juancalderonlaratilin-ai/micro3/docs/informe/informe_adc_uart_ieee.tex

% Compilar con XeLaTeX o LuaLaTeX (en Overleaf: Menu -> Compiler -> XeLaTeX)
\documentclass[11pt,letterpaper]{article}

% ---------------------------------------------------------------- página y fuente
\usepackage[margin=0.85in]{geometry}
\usepackage{fontspec}
\setmainfont{TeX Gyre Termes}          % tipo Times, como IEEE
\usepackage{amsmath,amssymb}
\usepackage{microtype}
\usepackage{booktabs,tabularx,array,float}
\usepackage{graphicx}
\usepackage{placeins}
\usepackage{enumitem}
\usepackage{titlesec}
\usepackage{caption}
\usepackage{xcolor}
\usepackage[hidelinks]{hyperref}
\usepackage[output-decimal-marker={,},group-separator={\,},group-minimum-digits=4,
            per-mode=symbol]{siunitx}

% ---------------------------------------------------------------- textos en español
\renewcommand{\tablename}{Tabla}
\renewcommand{\refname}{Referencias}
\renewcommand{\abstractname}{Resumen}
\renewcommand{\figurename}{Fig.}

% ---------------------------------------------------------------- estilo IEEE
\renewcommand{\thesection}{\Roman{section}}
\renewcommand{\thesubsection}{\Alph{subsection}}
\titleformat{\section}{\centering\scshape\large}{\thesection.}{0.5em}{}
\titleformat{\subsection}{\itshape}{\thesubsection.}{0.5em}{}
\titlespacing*{\section}{0pt}{1.3em}{0.6em}
\titlespacing*{\subsection}{0pt}{1.1em}{0.5em}

\renewcommand{\thetable}{\Roman{table}}
\captionsetup[table]{labelfont=sc, textfont=sc, labelsep=newline,
                     justification=centering, skip=6pt, font=small}
\captionsetup[figure]{labelsep=period, font=small, justification=justified, skip=4pt}

\setlength{\parindent}{1.2em}
\setlength{\parskip}{0.3em}
\renewcommand{\arraystretch}{1.2}
\setlength{\tabcolsep}{6pt}
\newcolumntype{Y}{>{\raggedright\arraybackslash}X}
\setlist{itemsep=0pt, topsep=3pt}

\definecolor{elegido}{RGB}{0,82,147}
\newcommand{\elegido}[1]{\textcolor{elegido}{#1}}   % resalta la opción elegida

\begin{document}

% ================================================================ título
\begin{center}
  {\LARGE Configuración del ADC y la UART del PIC16F18426\\[0.25em]
  en el instrumento de corrientes de Eddy}\\[0.9em]
  {\large Proyecto Micro 3 --- Microcontroladores}\\[0.3em]
  {\small Resumen de decisiones de diseño}
\end{center}

\vspace{0.6em}
\begin{abstract}
\noindent
El PIC16F18426 digitaliza las componentes en fase ($I$) y en cuadratura ($Q$) que entrega la placa de demodulación y las envía a un PC por UART. Este documento reúne, en un solo lugar, \emph{qué} se escogió para el ADC y la UART y \emph{por qué}, con los cálculos mínimos de cada valor. Los datos viajan como texto ASCII, una línea \texttt{2048,2051\textbackslash r\textbackslash n} por par. Resultado: muestreo de $I$ y $Q$ a \SI{1}{\kilo\hertz} disparado por hardware, enlace a \num{115200} baudios 8N1 y una línea cada dos pares (500 líneas/s), que ocupa el \SI{48}{\percent} de la línea; una línea por par la dejaría al \SI{96}{\percent}, sin margen.
\end{abstract}

% ================================================================ I
\section{Datos del sistema}

\noindent
PIC16F18426 (14 pines, 8 bits) con oscilador interno HFINTOSC a $F_\text{osc} = \SI{16}{\mega\hertz}$ (\SI{+-2}{\percent}), así que $T_\text{CY} = 4/F_\text{osc} = \SI{250}{\nano\second}$. Alimentación $V_{DD} = \SI{3.7}{\volt}$, accesible en J1, en TP3 y en el pin 2 de J4. Las señales $I$ (RC0) y $Q$ (RC1) llegan centradas en $V_\text{ref2} = \SI{1.85}{\volt}$, con banda de $\lesssim \SI{20}{\hertz}$. El enlace al PC es EUSART1 $\rightarrow$ traductores SN74LVC1T45 $\rightarrow$ CP2102 (USB) $\rightarrow$ LabVIEW o Python.

% ================================================================ II
\section{UART: qué se escogió y por qué}

La Tabla~\ref{tab:uart} resume cada decisión; abajo están los cálculos.

\begin{table}[!htb]
\caption{Decisiones de la UART}\label{tab:uart}
\centering
\begin{tabularx}{\textwidth}{@{}l>{\raggedright\arraybackslash}p{0.27\textwidth}Y@{}}
\toprule
\textbf{Parámetro} & \textbf{Elegido} & \textbf{Por qué} \\
\midrule
Modo & EUSART1 asíncrono, \textbf{8N1} & Estándar: lo acepta cualquier terminal, LabVIEW o Python sin configuración especial. \\
Velocidad & \textbf{\num{115200} baud} (\num{114286} reales) & Es el baud estándar más bajo donde caben 500 líneas/s de 11 bytes: ocupan el \SI{48}{\percent}. A \num{9600} y \num{19200} baud serían el \SI{573}{\percent} y el \SI{286}{\percent}; a \num{57600}, el \SI{95}{\percent}, sin margen. \\
Generador de baud & \texttt{BRGH}\,=\,1, \texttt{BRG16}\,=\,1, \texttt{SP1BRG}\,=\,34 & Error de \SI{-0.79}{\percent}; con el generador de 8 bits sería \SI{-3.55}{\percent}. \\
Pines & TX = RC4, RX = RC5 (PPS) & No chocan con el ADC (RC0, RC1) ni con el programador (RA0, RA1, RA3). \\
Nivel de RX & TTL (\texttt{INLVLC5}\,=\,0) & $V_{IH} = \SI{1.73}{\volt}$: \SI{1.57}{\volt} de margen con \SI{3.3}{\volt}. Con Schmitt serían \SI{2.96}{\volt}. \\
Capa física & 2 $\times$ SN74LVC1T45 & El CP2102 admite como máximo $V_{IO} + \SI{0.5}{\volt} = \SI{3.8}{\volt}$; el PIC saca \SI{3.7}{\volt}. \\
Atención & Interrupción de TX & Nada espera: prohibidos \texttt{while(!TX1IF)} y \texttt{\_\_delay\_ms}. El RX queda configurado, pero el PIC no recibe comandos. \\
Buffers & Circulares: RX \num{32} B, TX \num{64} B & Potencias de 2: el índice avanza con \texttt{(i+1)\,\&\,(N-1)}, sin división. TX guarda 4 líneas. \\
Envío & \texttt{tx\_DAT()}, \texttt{tx\_string()} & Todo o nada: nunca sale media línea; si no cabe, devuelven \texttt{false} sin esperar. \\
Formato & \textbf{Texto ASCII}, \texttt{xxxx,xxxx\textbackslash r\textbackslash n} & Ver la sección~\ref{sec:formato}. \\
\bottomrule
\end{tabularx}
\end{table}

\subsection{Cálculo del baud}
Con \texttt{BRGH}\,=\,1 y \texttt{BRG16}\,=\,1:
\begin{gather}
  \text{Baud} = \frac{F_\text{osc}}{4\,(\text{SP1BRG}+1)} = \frac{\SI{16}{\mega\hertz}}{4\,(34+1)} = \num{114286}\ \text{baud} \\[2pt]
  \text{error} = \frac{\num{114286} - \num{115200}}{\num{115200}} = \SI{-0.79}{\percent}
\end{gather}
La fórmula de 8 bits, $\text{Baud} = F_\text{osc}/[16(\text{SP1BRG}+1)]$, da $\text{SP1BRG} = 7{,}68 \rightarrow 8$ y \num{111111} baud (\SI{-3.55}{\percent}), demasiado lejos si se suma el \SI{+-2}{\percent} del oscilador.

\textbf{Tolerancia.} El receptor muestrea el bit de parada a 9,5 bits del flanco de inicio, así que el desfase total debe ser menor que $0{,}5/9{,}5 = \SI{+-5.3}{\percent}$ (en la práctica, entre \SI{2}{\percent} y \SI{3}{\percent}). Peor caso: $\SI{-0.79}{\percent} - \SI{2}{\percent} \approx \SI{-2.8}{\percent}$: funciona.

\textbf{Tiempos.} $T_\text{bit} = \SI{8.75}{\micro\second}$, byte 8N1 (10 bits) $= \SI{87.5}{\micro\second}$, capacidad $\approx \SI{11429}{\byte\per\second}$.

\textbf{Verificado:} eco a \num{115200} baud con 20/20, 256/256 y 1000/1000 bytes sin errores (2026-10-19).

% ================================================================ III
\section{ADC: qué se escogió y por qué}

La Tabla~\ref{tab:adc} resume cada decisión; abajo están los cálculos.

\begin{table}[!htb]
\caption{Decisiones del ADC}\label{tab:adc}
\centering
\begin{tabularx}{\textwidth}{@{}l>{\raggedright\arraybackslash}p{0.27\textwidth}Y@{}}
\toprule
\textbf{Parámetro} & \textbf{Elegido} & \textbf{Por qué} \\
\midrule
Convertidor & ADCC de 12 bits, modo básico, resultado a la derecha & 4096 niveles; 1 LSB $= \SI{0.903}{\milli\volt}$. \\
Referencia & $V_\text{ref+} = V_{DD} = \SI{3.7}{\volt}$ (\texttt{ADREF}\,=\,0x00) & Cubre 0 a \SI{3.7}{\volt} sin recorte y es ratiométrica: $V_\text{ref2}$ sale de un divisor del mismo riel, así que el reposo queda en 2048 aunque $V_{DD}$ varíe. FVR de \SI{2.048}{\volt}: recorta; FVR de \SI{4.096}{\volt}: no puede superar $V_{DD}$. \\
Canales & $I$ = RC0 (0x10), $Q$ = RC1 (0x11) & Un solo ADC multiplexado: $I$ y luego $Q$ en ráfaga. \\
Muestreo & $f_s = \SI{1}{\kilo\hertz}$ & Pedido por el profesor. Con señal $\lesssim \SI{20}{\hertz}$: sobremuestreo de 25; Nyquist en \SI{500}{\hertz}. Al PC llega 1 de cada 2 pares (\SI{500}{\hertz}). \\
Disparo & Timer0 por hardware (\texttt{ADACT}\,=\,0x02) & El instante de $I$ no depende del software (sin jitter de código). El Timer2 queda para el PWM. \\
Timer0 & $F_\text{osc}/4$, prescaler 1:16, \texttt{TMR0H}\,=\,249 & Periodo exacto de \SI{1000}{\micro\second} sin recargar por software. \\
Reloj del ADC & $T_{AD} = \SI{2}{\micro\second}$ (\texttt{ADCLK} $= F_\text{osc}/32$) & Dentro del rango permitido (0,5 a \SI{9}{\micro\second}); conversión de \SI{28.5}{\micro\second}. \\
Adquisición & \texttt{ADACQ}\,=\,160 & El datasheet es ambiguo: 10, 40 o \SI{320}{\micro\second}. Los tres casos caben en 1 ms; se mide con el pin marcador. \\
Promedio & Ninguno & Cada línea lleva una sola muestra de $I$ y una de $Q$. \\
Entrada al pin & \SI{1}{\kilo\ohm} en serie + \SI{10}{\nano\farad} a GND & Aísla al operacional MCP604 de la carga del S\&H y sirve de depósito de carga. Pide $T_\text{ACQ} \gtrsim \SI{40}{\micro\second}$ (ver abajo). \\
\bottomrule
\end{tabularx}
\end{table}

\subsection{Cálculos}
\begin{gather}
  1\ \text{LSB} = \frac{V_{DD}}{4096} = \SI{0.9033}{\milli\volt}, \qquad
  N(\SI{1.85}{\volt}) = \frac{1{,}85}{3{,}7}\times 4096 = 2048 \\[2pt]
  T_s = (\texttt{TMR0H} + 1)\cdot \frac{16}{F_\text{osc}/4} = 250 \times \SI{4}{\micro\second} = \SI{1000}{\micro\second} \\[2pt]
  T_\text{conv} = 14\,T_{AD} + 2\,T_\text{CY} = 14(\SI{2}{\micro\second}) + 2(\SI{0.25}{\micro\second}) = \SI{28.5}{\micro\second}
\end{gather}

\textbf{Calidad.} El ideal de 12 bits es $\text{SINAD} = 6{,}02\cdot 12 + 1{,}76 = \SI{74}{\decibel}$. El requisito de \SI{60}{\decibel} equivale a $\text{ENOB} = (60-1{,}76)/6{,}02 = 9{,}67$ bits: con una senoidal a escala completa (\SI{1.31}{\volt} rms) se permiten \SI{1.31}{\milli\volt} rms de ruido y distorsión, unos 1,45 LSB. El ruido de cuantización es $\text{LSB}/\sqrt{12} = \SI{0.261}{\milli\volt}$ rms.

\textbf{Sesgo entre $I$ y $Q$.} La muestra de $Q$ se toma $\approx \SI{46}{\micro\second}$ después de la de $I$ (con \SI{10}{\micro\second} de adquisición). A \SI{20}{\hertz} eso es $360^\circ \cdot 20 \cdot \SI{46}{\micro\second} = 0{,}33^\circ$ de error de fase: despreciable.

\textbf{Red de \SI{1}{\kilo\ohm} + \SI{10}{\nano\farad}.} Al conectarse el capacitor interno ($C_\text{HOLD} = \SI{28}{\pico\farad}$), el pin salta solo $28/10\,028 = \SI{0.28}{\percent}$ de la diferencia con el canal anterior. Luego se recupera con $\tau = \SI{1}{\kilo\ohm}\cdot\SI{10}{\nano\farad} = \SI{10}{\micro\second}$. La mezcla de $I$ en $Q$ queda en \SI{-60}{\decibel} con \SI{10}{\micro\second} de adquisición y en \SI{-86}{\decibel} con \SI{40}{\micro\second}; por eso no conviene acortarla por debajo de unos \SI{40}{\micro\second}.

% ================================================================ IV
\section{Formato de los datos: texto ASCII}
\label{sec:formato}

\subsection{La línea que se transmite}

\begin{table}[!htb]
\caption{Línea de texto. Ejemplo: $I = 2048$, $Q = 2051$}
\centering
\begin{tabular}{@{}lccccccccccc@{}}
\toprule
\textbf{Byte} & 0 & 1 & 2 & 3 & 4 & 5 & 6 & 7 & 8 & 9 & 10 \\
\textbf{Carácter} & \texttt{2} & \texttt{0} & \texttt{4} & \texttt{8} & \texttt{,} & \texttt{2} & \texttt{0} & \texttt{5} & \texttt{1} & CR & LF \\
\textbf{Hex} & \texttt{32} & \texttt{30} & \texttt{34} & \texttt{38} & \texttt{2C} & \texttt{32} & \texttt{30} & \texttt{35} & \texttt{31} & \texttt{0D} & \texttt{0A} \\
\bottomrule
\end{tabular}
\end{table}

\noindent
$I$ y $Q$ van en decimal, de 0 a 4095, sin ceros a la izquierda: hasta 11 bytes por línea. Primero va $I$ y después $Q$, sin nombres: el orden dice cuál es cuál. Dos números separados por coma los dibuja directo el Serial Plotter de Arduino. El PC lee hasta \texttt{\textbackslash n} y separa los números con \texttt{\%d,\%d}; una línea con otra forma se descarta.

\subsection{Cuántas líneas por segundo}

Una línea de 11 bytes tarda $11 \times \SI{87.5}{\micro\second} = \SI{962.5}{\micro\second}$, casi todo el periodo de muestreo. Por eso el PIC manda una línea cada dos pares (\texttt{ADC\_PARES\_POR\_LINEA}\,=\,2), como resume la Tabla~\ref{tab:ocup}.

\begin{table}[!htb]
\caption{Ocupación de la línea a \num{114286} baud}\label{tab:ocup}
\centering
\begin{tabularx}{\textwidth}{@{}lYYY@{}}
\toprule
 & \textbf{1 línea por par} & \textbf{\elegido{1 cada 2 pares (elegido)}} & \textbf{1 cada 50 pares} \\
\midrule
Líneas por segundo ($f_s$ en el PC) & 1000 & \textbf{500} & 20 \\
Bytes por segundo & \num{11000} & \textbf{\num{5500}} & 220 \\
Ocupación & \SI{96}{\percent}: \textbf{sin margen} & \textbf{\SI{48}{\percent}} & \SI{1.9}{\percent} \\
Nyquist en el PC & \SI{500}{\hertz} & \textbf{\SI{250}{\hertz}} & \SI{10}{\hertz} \\
Sirve para SINAD a 5 y \SI{20}{\hertz} & --- & \textbf{sí} (armónicos 2 a 5 $\le$ \SI{100}{\hertz}) & no \\
\bottomrule
\end{tabularx}
\end{table}

\subsection{Conversión a decimal en el PIC}

El PIC16 no tiene divisor por hardware, así que \texttt{a\_decimal()} saca cada cifra restando 1000, 100, 10 y 1 tantas veces como quepa (hasta 18 restas de 16 bits para 4095) y le suma \texttt{'0'} (\texttt{0x30}). Previsión: $\approx\SI{95}{\micro\second}$ por valor; con el texto fijo y la copia al buffer (\texttt{tx\_string}), $\approx\SI{280}{\micro\second}$ por línea, una vez cada \SI{2}{\milli\second}.

\subsection{Ventajas y límites}

\begin{itemize}
  \item[+] Se lee directo en una terminal o en el Serial Plotter, y el fin de línea sincroniza solo.
  \item[+] En LabVIEW basta \emph{VISA Read} con el carácter de fin \texttt{\textbackslash n} y \emph{Scan From String}; es el formato que sugiere el enunciado.
  \item[+] El PIC empieza a mandar al encenderse: el PC no tiene que pedir nada.
  \item[+] Sin nombres la línea es corta (11 bytes): a 500 líneas/s usa menos de la mitad de la UART.
  \item[$-$] El PC depende del orden: el primer número es $I$ y el segundo $Q$.
  \item[$-$] Al PC llega 1 de cada 2 pares ($f_s = \SI{500}{\hertz}$); suficiente para señales $\lesssim \SI{20}{\hertz}$.
  \item[$-$] Sin verificación de errores ni número de secuencia: una línea dañada se descarta si deja de tener la forma «número,número»; una perdida no se ve (se revisa el contador \texttt{adcLineasPerdidas} del PIC).
  \item[$-$] El PC no puede mandar comandos (el control del PWM queda por definir).
\end{itemize}

% ================================================================ V
\section{Diagramas de tiempo}

Las Figs.~\ref{fig:periodo}--\ref{fig:ocup} se generaron con el script \texttt{generar\_diagramas\_tiempo.m} (MATLAB). Los tiempos del ADC y de la UART son exactos: salen del datasheet (conversión de \SI{28.5}{\micro\second}, latencia de interrupción) o de los registros (periodo de \SI{1}{\milli\second}, \num{114286} baud, línea de \SI{962.5}{\micro\second}). Los tiempos de CPU son una \emph{previsión}: se estimaron contando instrucciones a 4 instrucciones/\si{\micro\second} y se medirán con un pin marcador y el osciloscopio. Todas las figuras suponen una adquisición de \SI{10}{\micro\second}.

\begin{figure}[!ht]
\centering
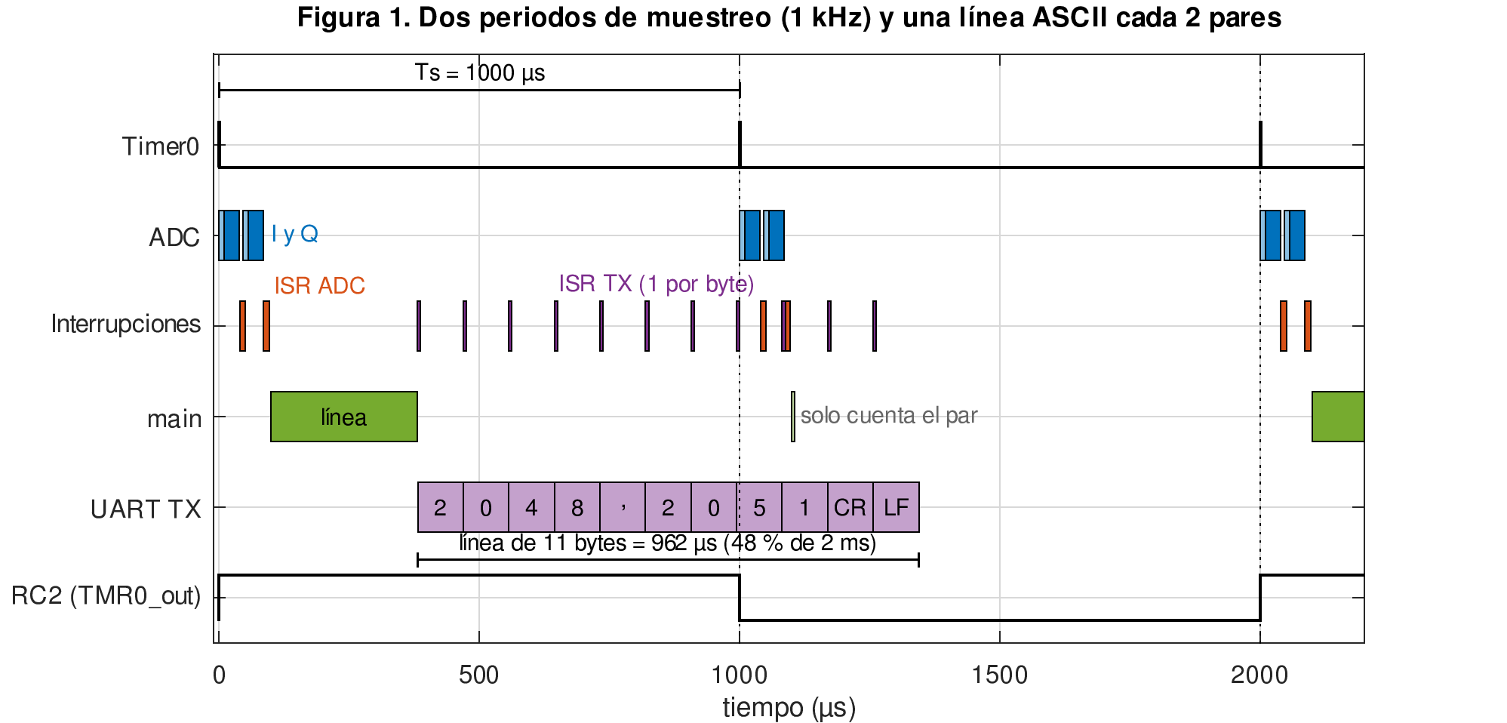
[picture p1: docs/informe/figuras/fig1_periodo_2ms.png]

\caption{Dos periodos de muestreo. El Timer0 dispara la conversión de $I$ por hardware en $t = 0$ y en $t = \SI{1000}{\micro\second}$; cada ráfaga $I + Q$ termina hacia los \SI{97}{\micro\second}. En el primer tick el programa principal arma la línea ($\approx$\SI{280}{\micro\second}); en el segundo solo cuenta el par. La línea ocupa la UART \SI{962.5}{\micro\second} (\SI{48}{\percent} de \SI{2}{\milli\second}) y sus interrupciones de TX caen sobre la ráfaga siguiente, donde pueden retrasar unos \SI{6}{\micro\second} el arranque de $Q$. RC2 saca la salida del Timer0: cambia de nivel en cada disparo.}
\label{fig:periodo}
\end{figure}

\begin{figure}[!ht]
\centering
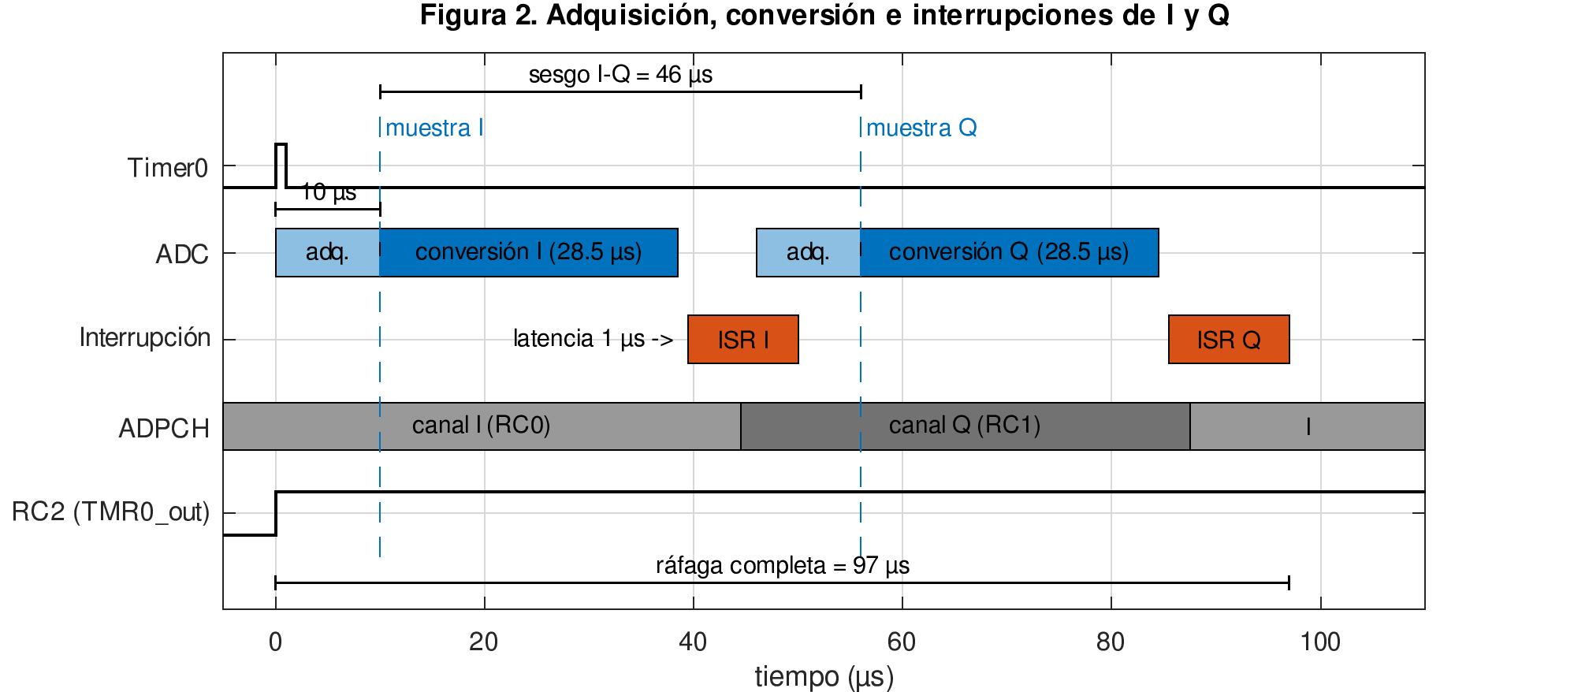
[picture p2: docs/informe/figuras/fig2_rafaga_IQ.png]

\caption{Lectura del ADC. Cada canal tiene \SI{10}{\micro\second} de adquisición y \SI{28.5}{\micro\second} de conversión ($14\,T_{AD} + 2\,T_\text{CY}$). Al terminar $I$, la interrupción (latencia de \SIrange{0.75}{1}{\micro\second}) lee \texttt{ADRES}, cambia \texttt{ADPCH} a RC1 y arranca $Q$. Por eso la muestra de $Q$ queda $\approx$\SI{46}{\micro\second} después de la de $I$.}
\label{fig:rafaga}
\end{figure}

\begin{figure}[!ht]
\centering
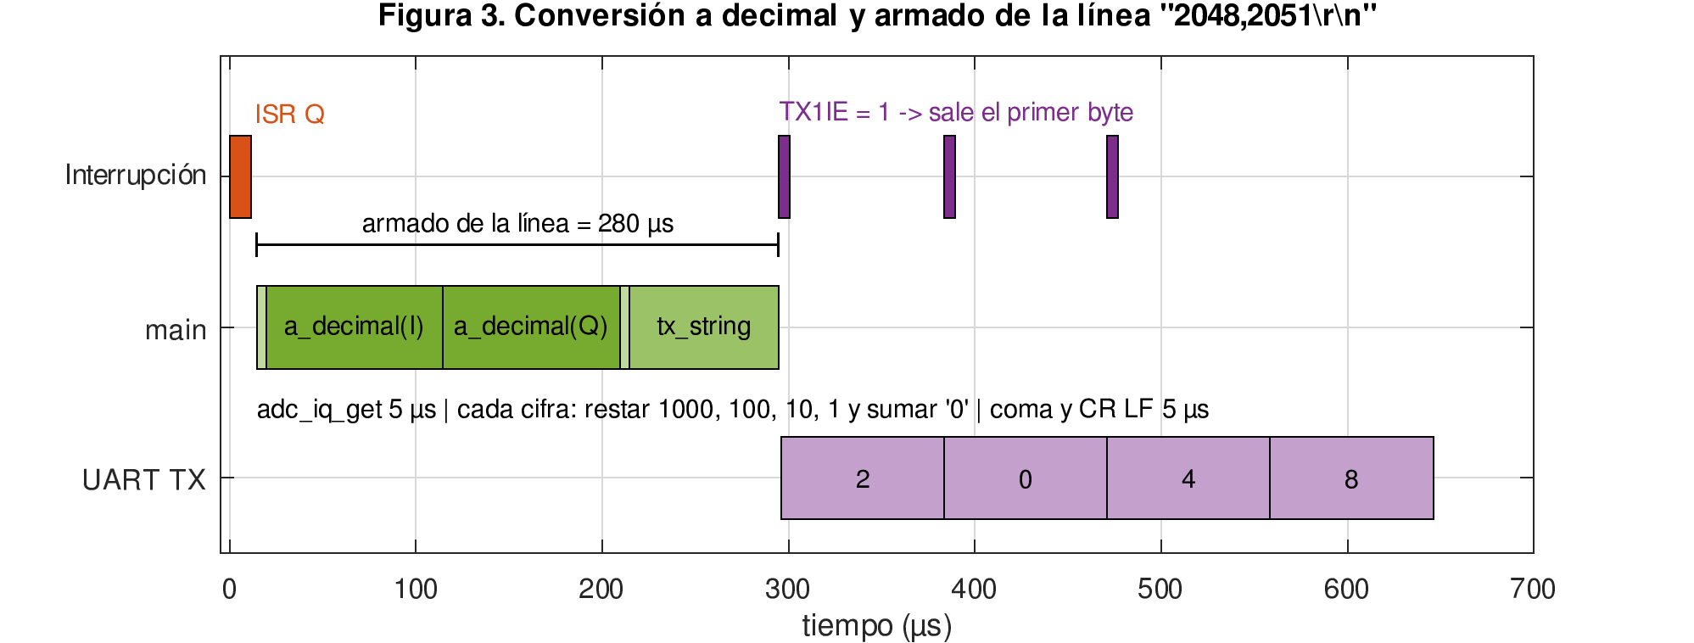
[picture p3: docs/informe/figuras/fig3_armado_linea.png]

\caption{Conversión a decimal y armado de la línea. Lo que más tarda es \texttt{a\_decimal()} ($\approx$\SI{95}{\micro\second} por valor), seguido de la copia de los 11 bytes al buffer de TX con \texttt{tx\_string} ($\approx$\SI{80}{\micro\second}). Al poner \texttt{TX1IE} = 1, la interrupción de TX carga los primeros bytes y la línea empieza a salir.}
\label{fig:armado}
\end{figure}

\begin{figure}[!ht]
\centering
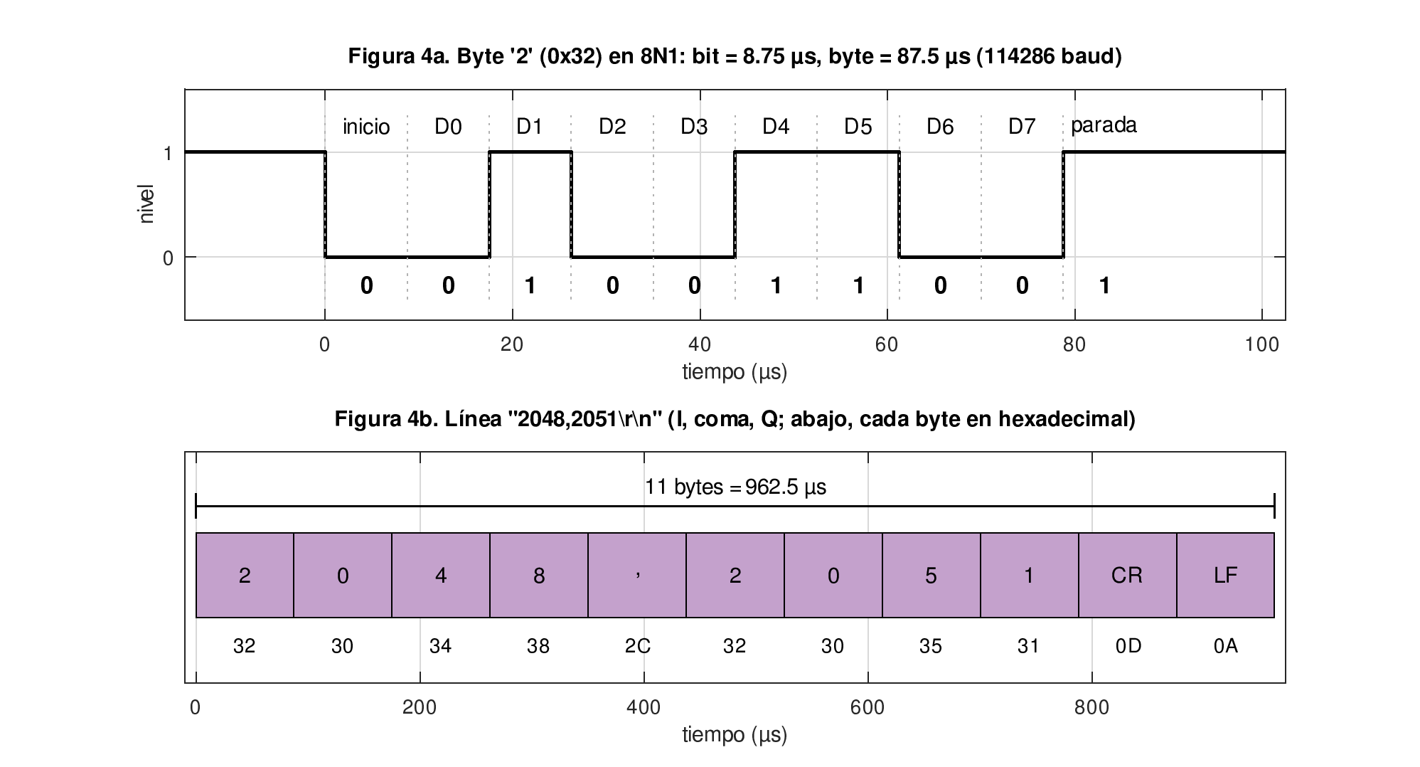
[picture p4: docs/informe/figuras/fig4_byte_linea.png]

\caption{(a) Byte \texttt{'2'} (\texttt{0x32}) en la línea: bit de inicio en 0, los 8 datos empezando por el menos significativo (0,1,0,0,1,1,0,0) y bit de parada en 1. Cada bit dura \SI{8.75}{\micro\second} y el byte \SI{87.5}{\micro\second}. (b) Línea completa del ejemplo $I = 2048$, $Q = 2051$: 11 bytes, \SI{962.5}{\micro\second}.}
\label{fig:byte}
\end{figure}

\begin{figure}[!ht]
\centering
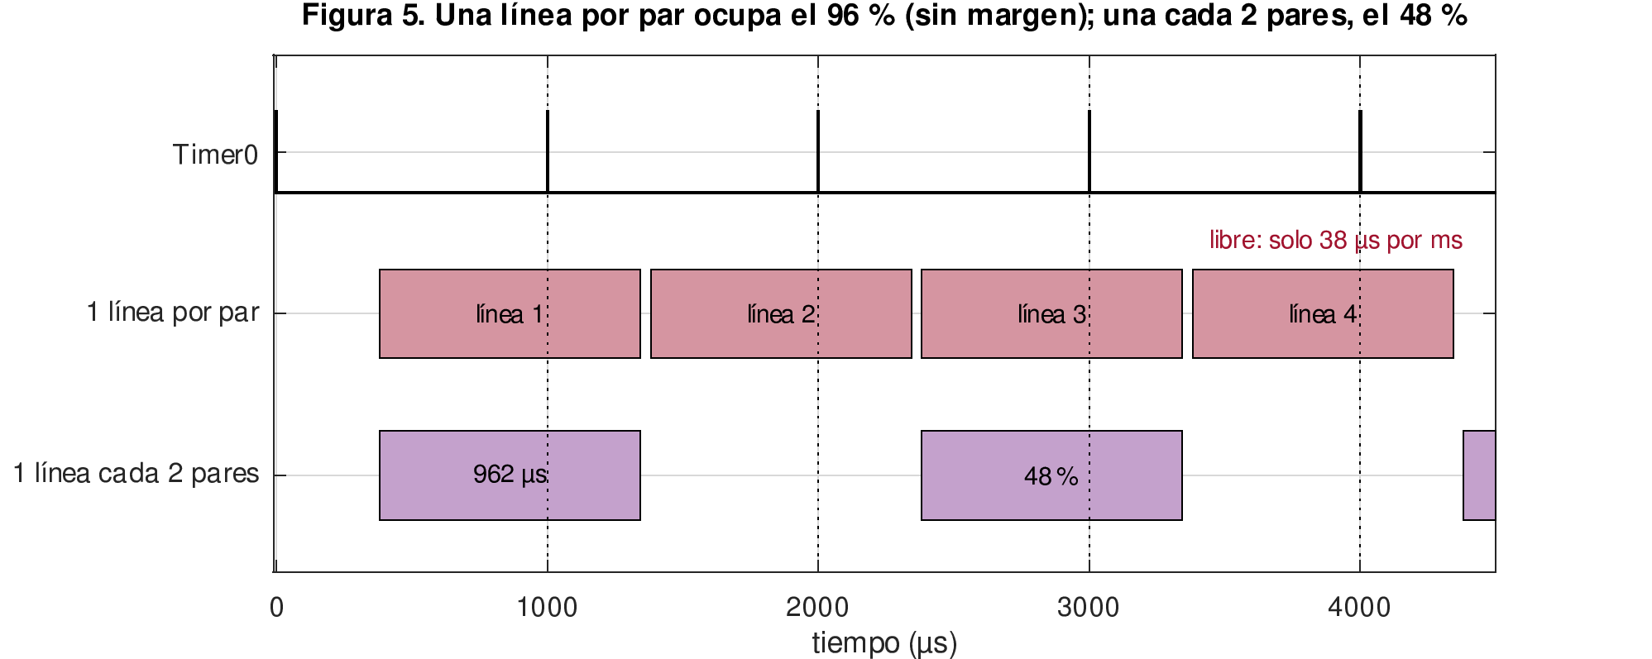
[picture p5: docs/informe/figuras/fig5_ocupacion_linea.png]

\caption{Por qué una línea cada dos pares. Con una línea por par, cada línea (\SI{962.5}{\micro\second}) ocupa casi todo el periodo de \SI{1}{\milli\second}: la UART queda ocupada el \SI{96}{\percent} y cualquier atraso llena el buffer de TX. Con una cada dos pares la línea queda libre el \SI{52}{\percent} del tiempo.}
\label{fig:ocup}
\end{figure}

\FloatBarrier

% ================================================================ referencias
\begin{thebibliography}{9}\small\setlength{\itemsep}{0pt}
\bibitem{ds} Microchip Technology, \emph{PIC16(L)F18426/46 Data Sheet}, DS40001985C (ADCC, EUSART, Timer0, parámetros AD20 y AD22).
\bibitem{lvc} Texas Instruments, \emph{SN74LVC1T45 Single-Bit Dual-Supply Bus Transceiver}, SCES515.
\bibitem{cp} Silicon Labs, \emph{CP2102 Single-Chip USB to UART Bridge}.
\end{thebibliography}

\end{document}
