juancalderonlaratilin-ai/micro3/docs/circuito_uart.png

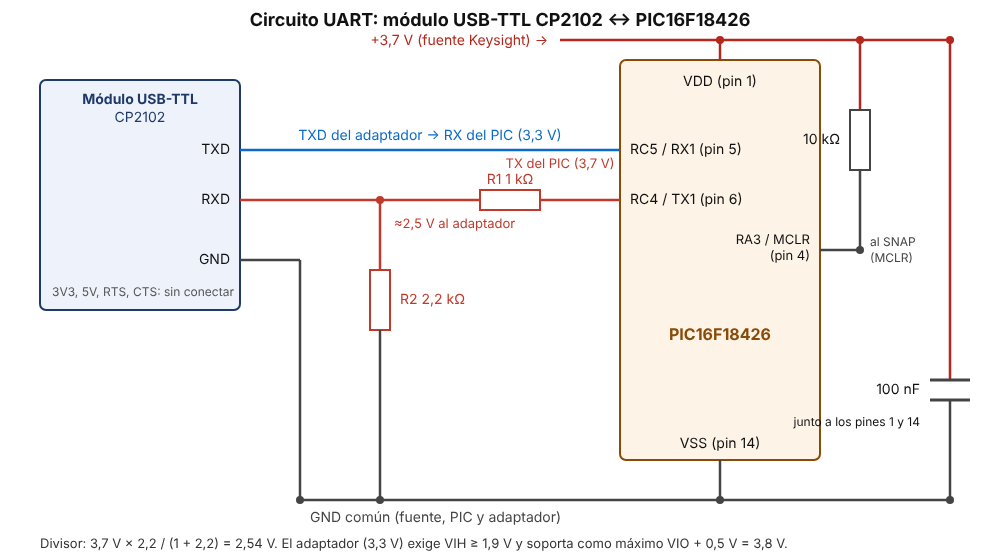
docs/circuito_uart.png
