juancalderonlaratilin-ai/micro3/docs/diagramas_tiempo/D1_periodo_1ms.png

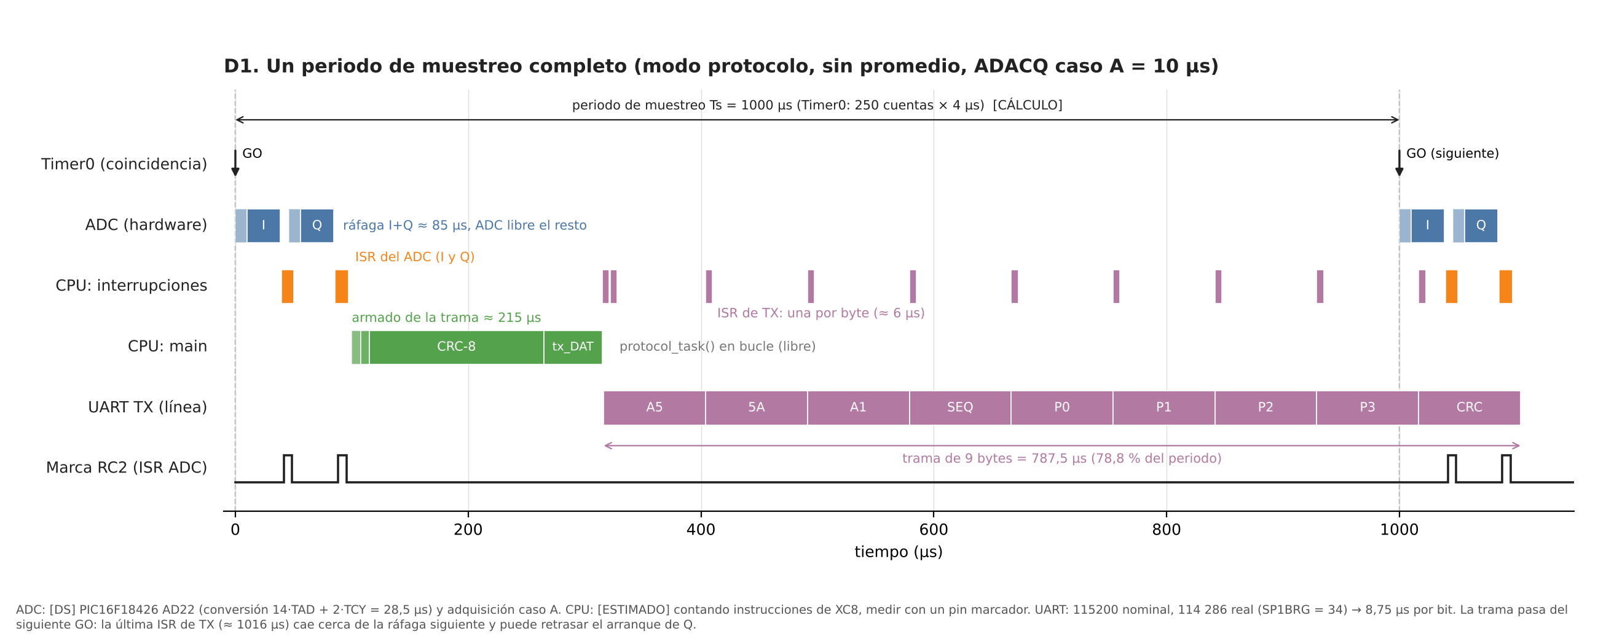
docs/diagramas_tiempo/D1_periodo_1ms.png
