juancalderonlaratilin-ai/micro3/docs/diagramas_tiempo/D4_byte_y_trama.png

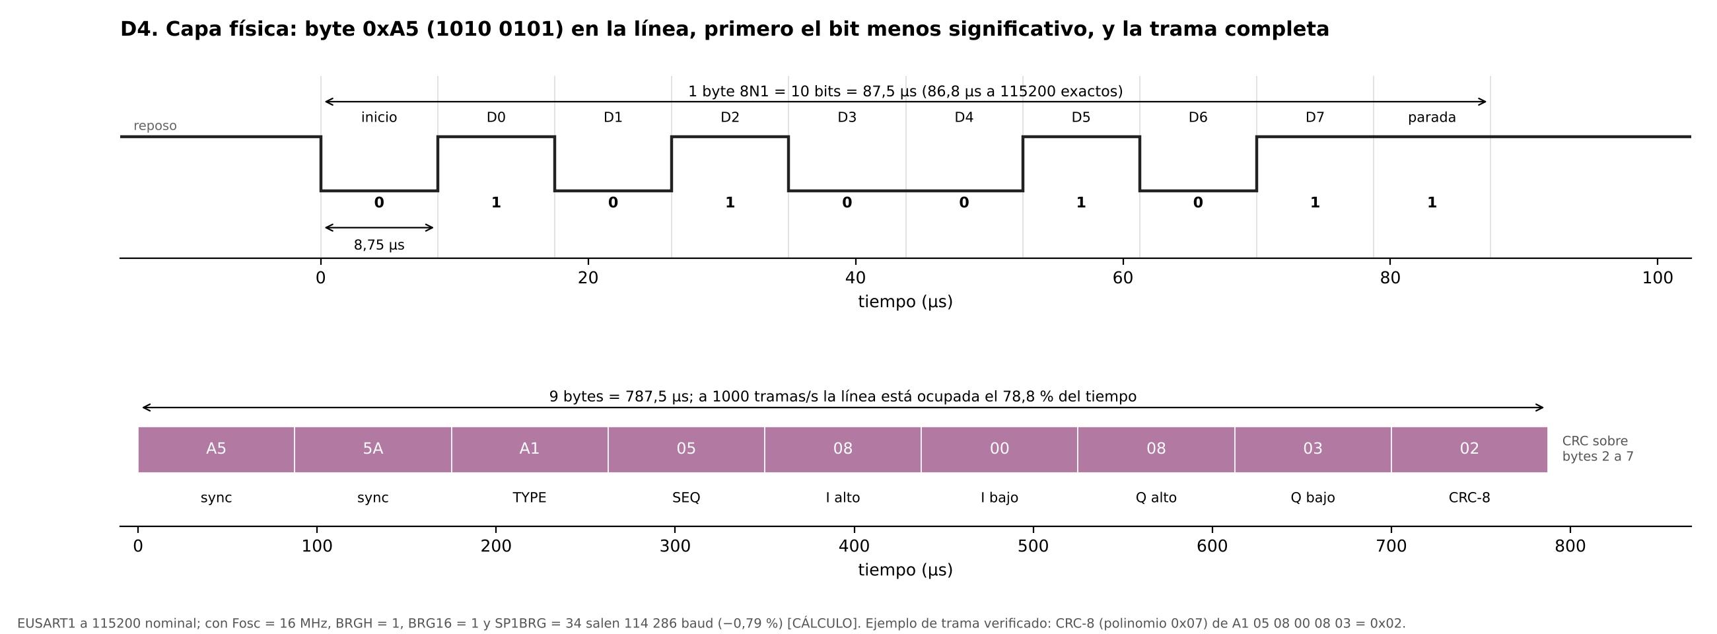
docs/diagramas_tiempo/D4_byte_y_trama.png
