juancalderonlaratilin-ai/micro3/docs/diagramas_tiempo/D5_camino_ASCII.png

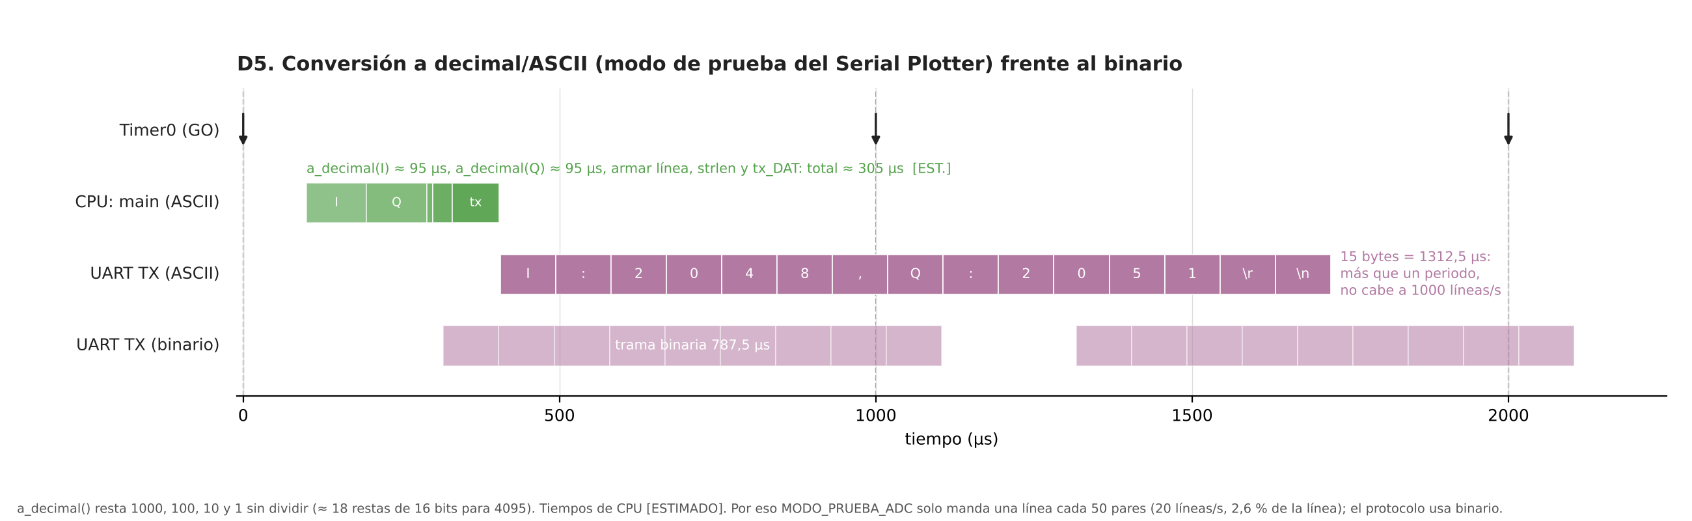
docs/diagramas_tiempo/D5_camino_ASCII.png
