juancalderonlaratilin-ai/micro3/docs/diagramas_tiempo/matlab/figuras/fig1_periodo_2ms.png

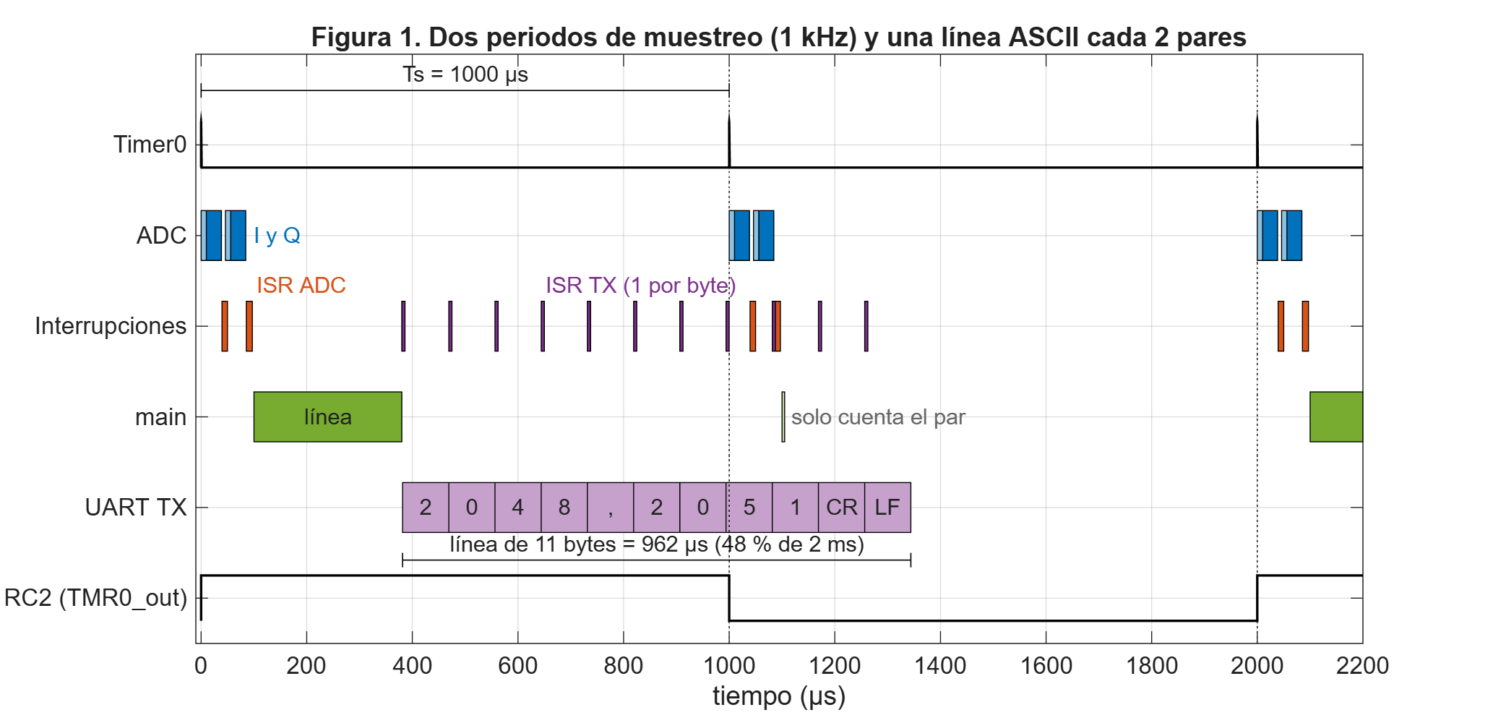
docs/diagramas_tiempo/matlab/figuras/fig1_periodo_2ms.png
