juancalderonlaratilin-ai/micro3/docs/diagramas_tiempo/matlab/figuras/fig2_rafaga_IQ.png

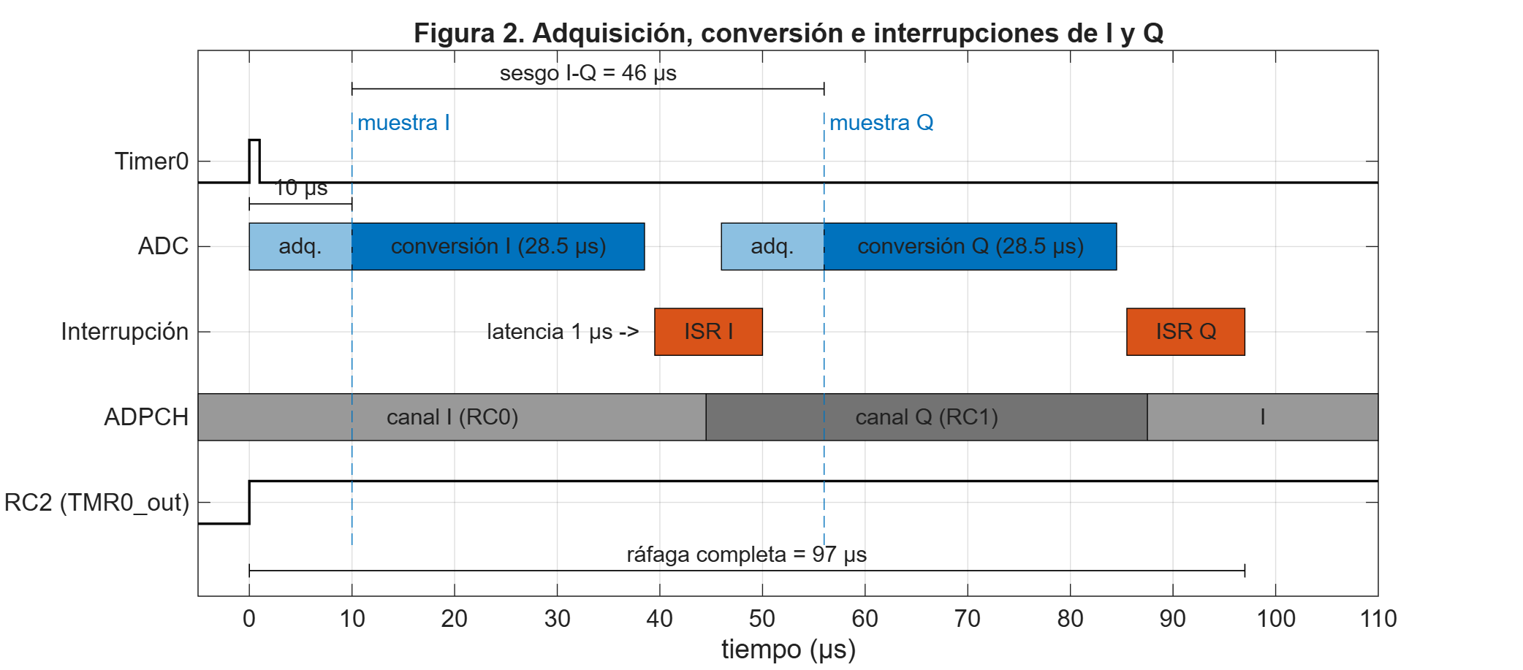
docs/diagramas_tiempo/matlab/figuras/fig2_rafaga_IQ.png
