juancalderonlaratilin-ai/micro3/docs/diagramas_tiempo/matlab/figuras/fig4_byte_linea.png

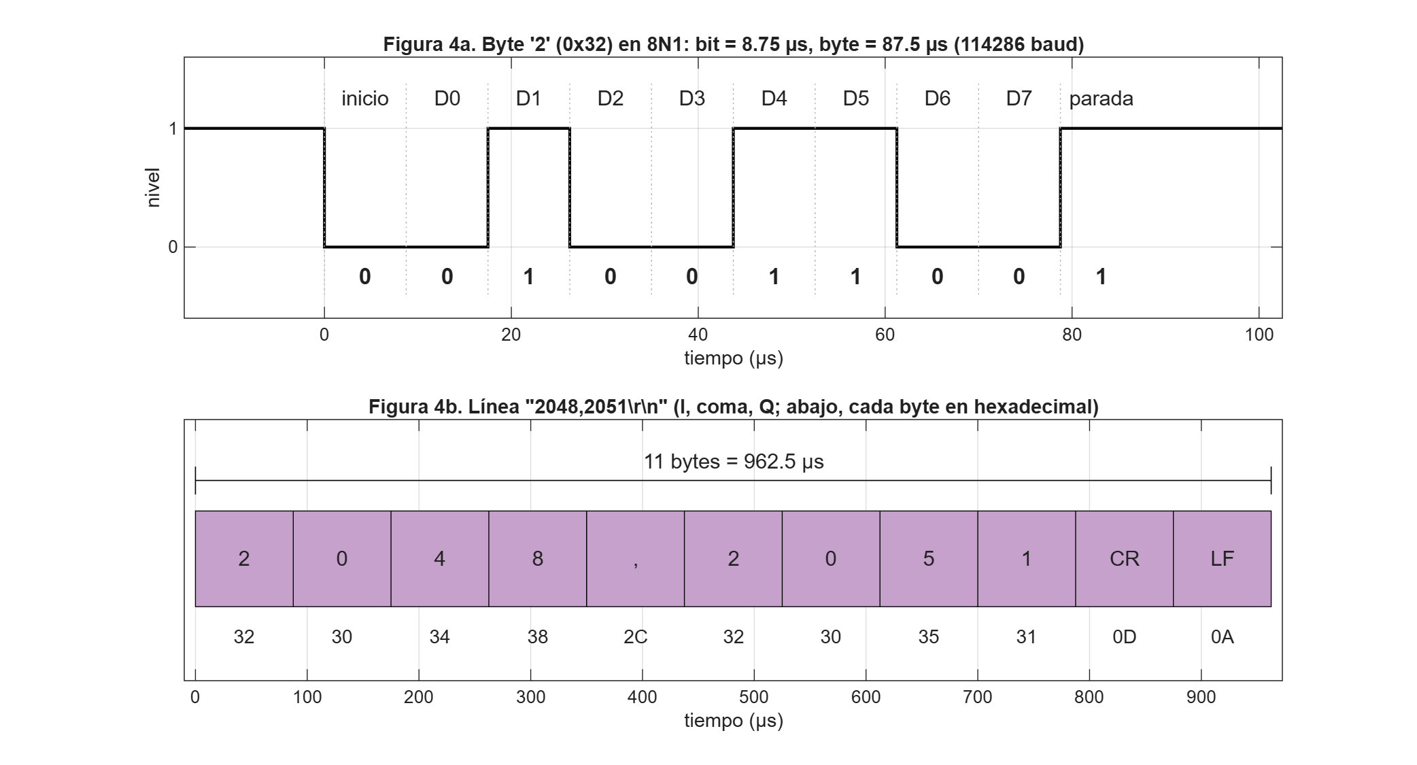
docs/diagramas_tiempo/matlab/figuras/fig4_byte_linea.png
