juancalderonlaratilin-ai/micro3/docs/diagramas_tiempo/matlab/figuras/fig5_ocupacion_linea.png

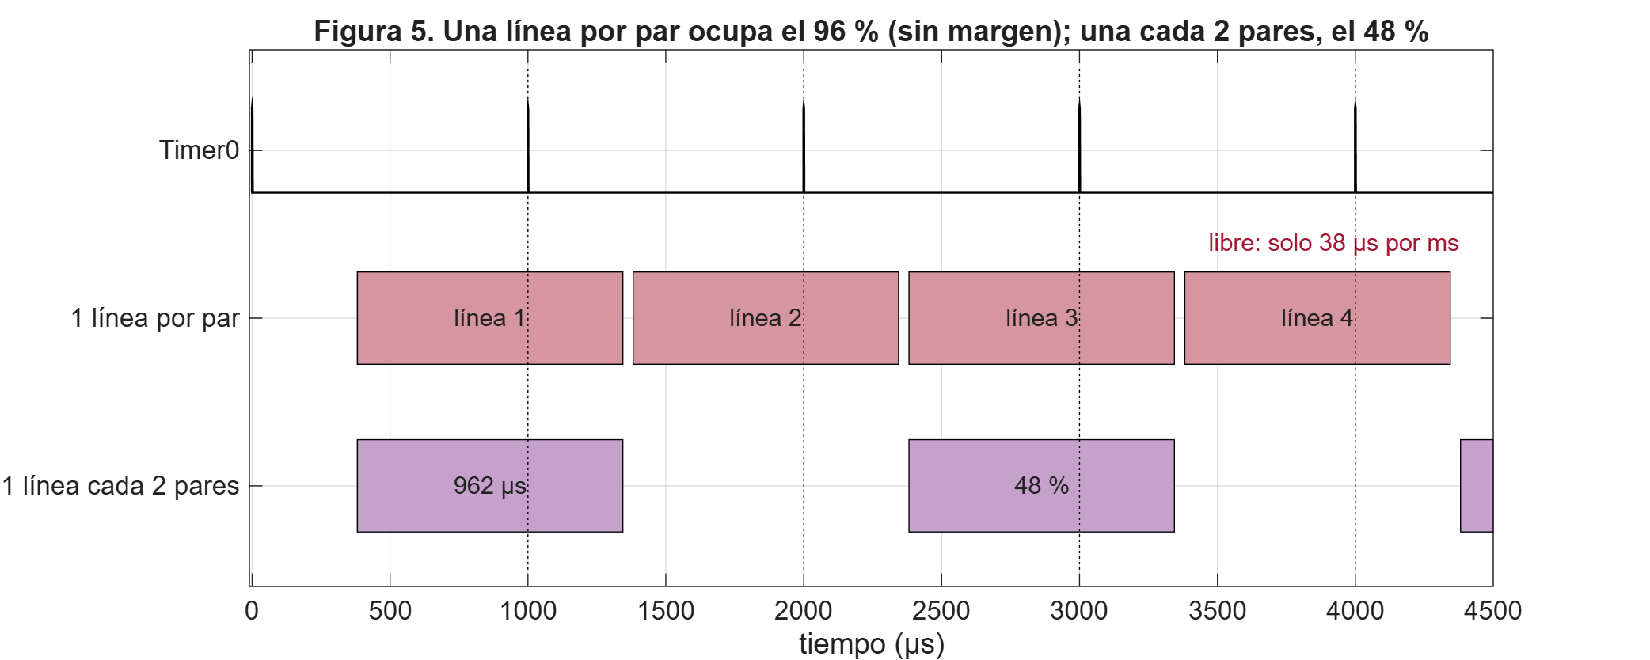
docs/diagramas_tiempo/matlab/figuras/fig5_ocupacion_linea.png
