juancalderonlaratilin-ai/micro3/docs/informe/figuras/fig1_periodo_1ms.png

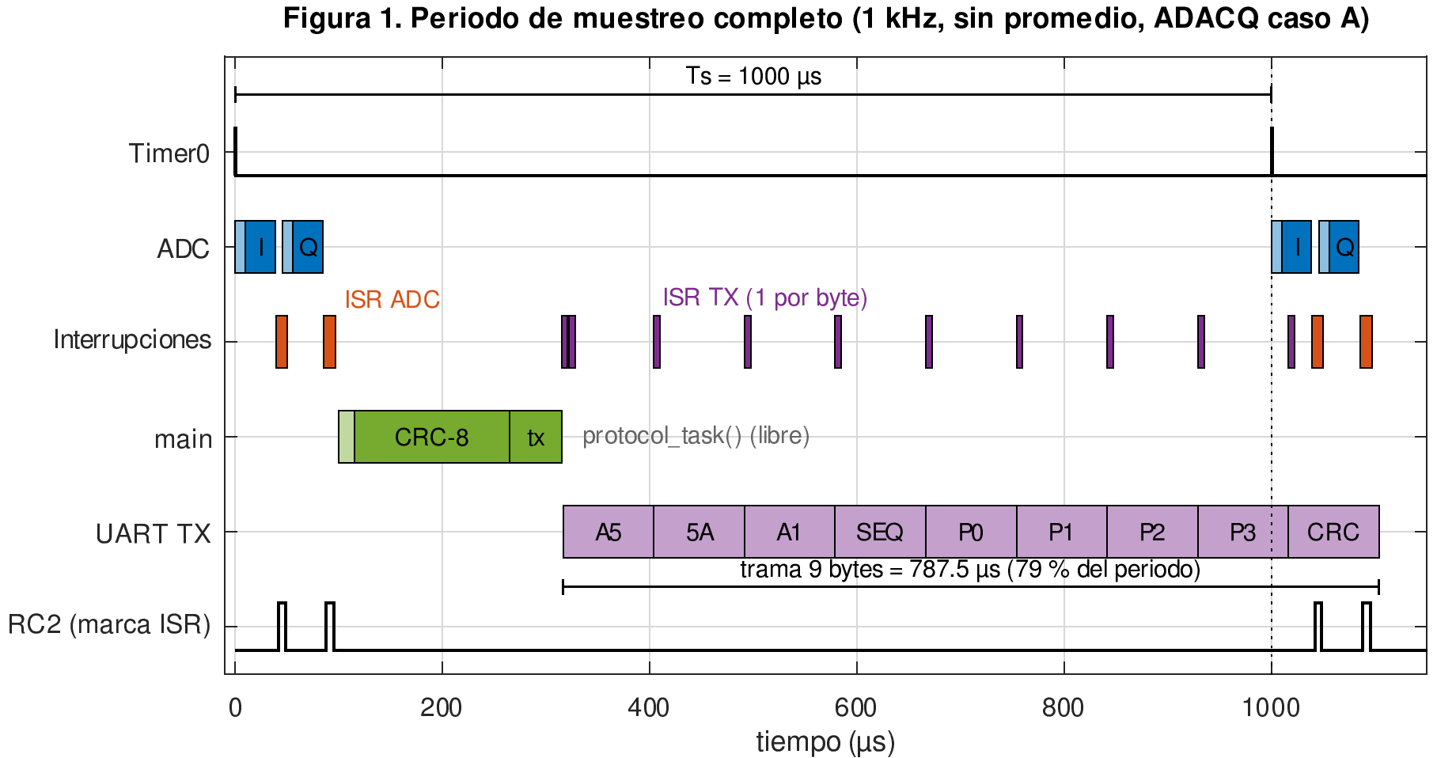
docs/informe/figuras/fig1_periodo_1ms.png
