juancalderonlaratilin-ai/micro3/docs/informe/figuras/fig4_byte_trama.png

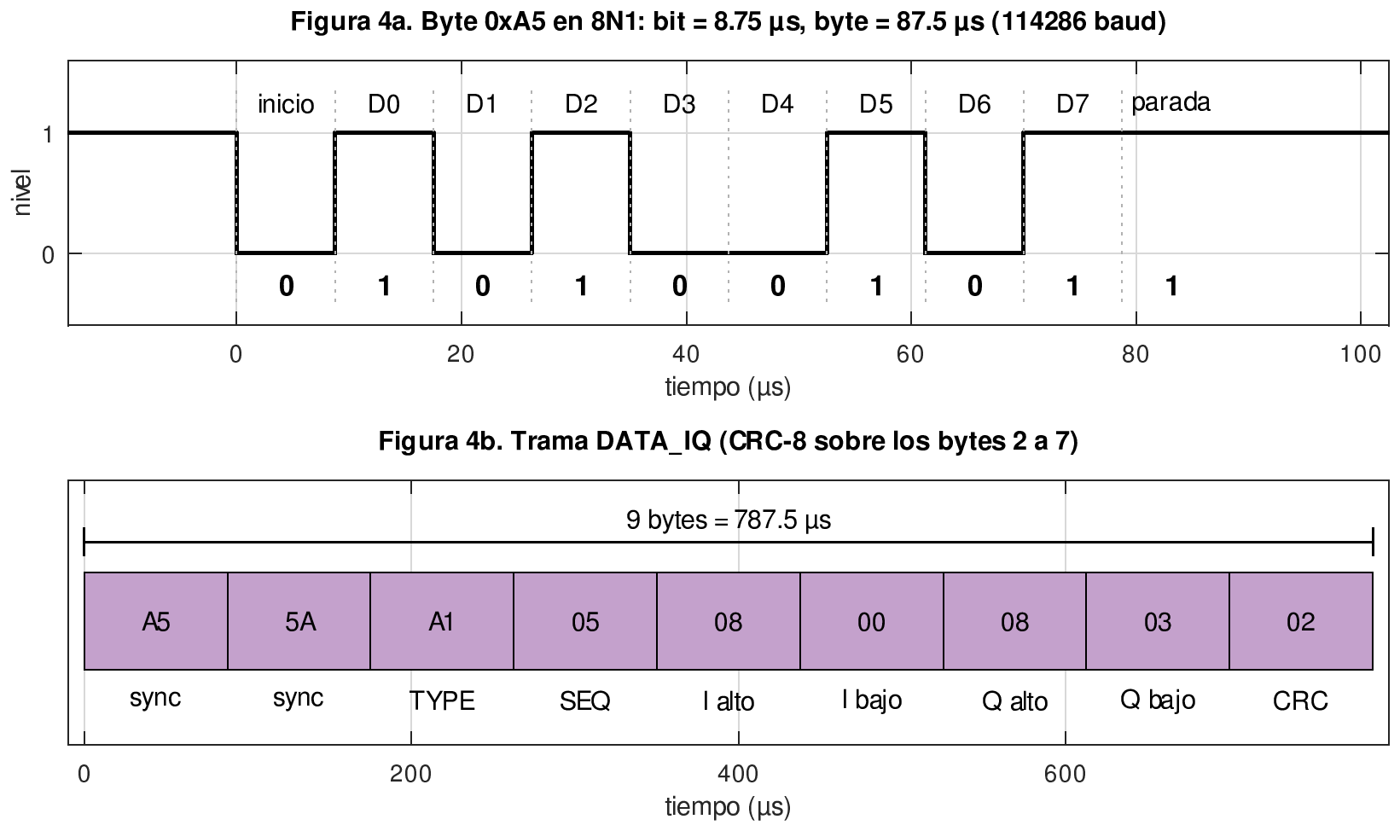
docs/informe/figuras/fig4_byte_trama.png
