juancalderonlaratilin-ai/micro3/docs/informe/figuras/fig5_ascii_binario.png

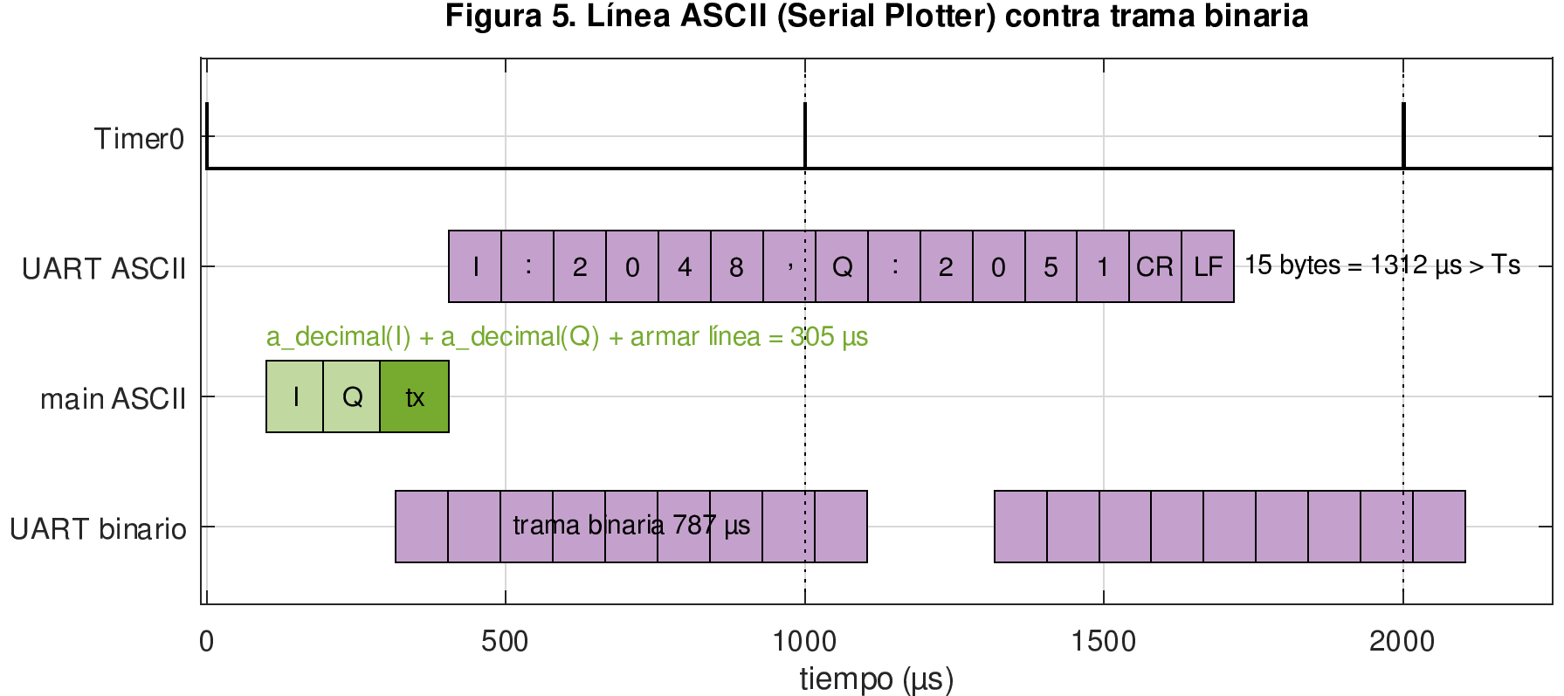
docs/informe/figuras/fig5_ascii_binario.png
