juancalderonlaratilin-ai/micro3/docs/diagramas_tiempo/D3_armado_trama.png

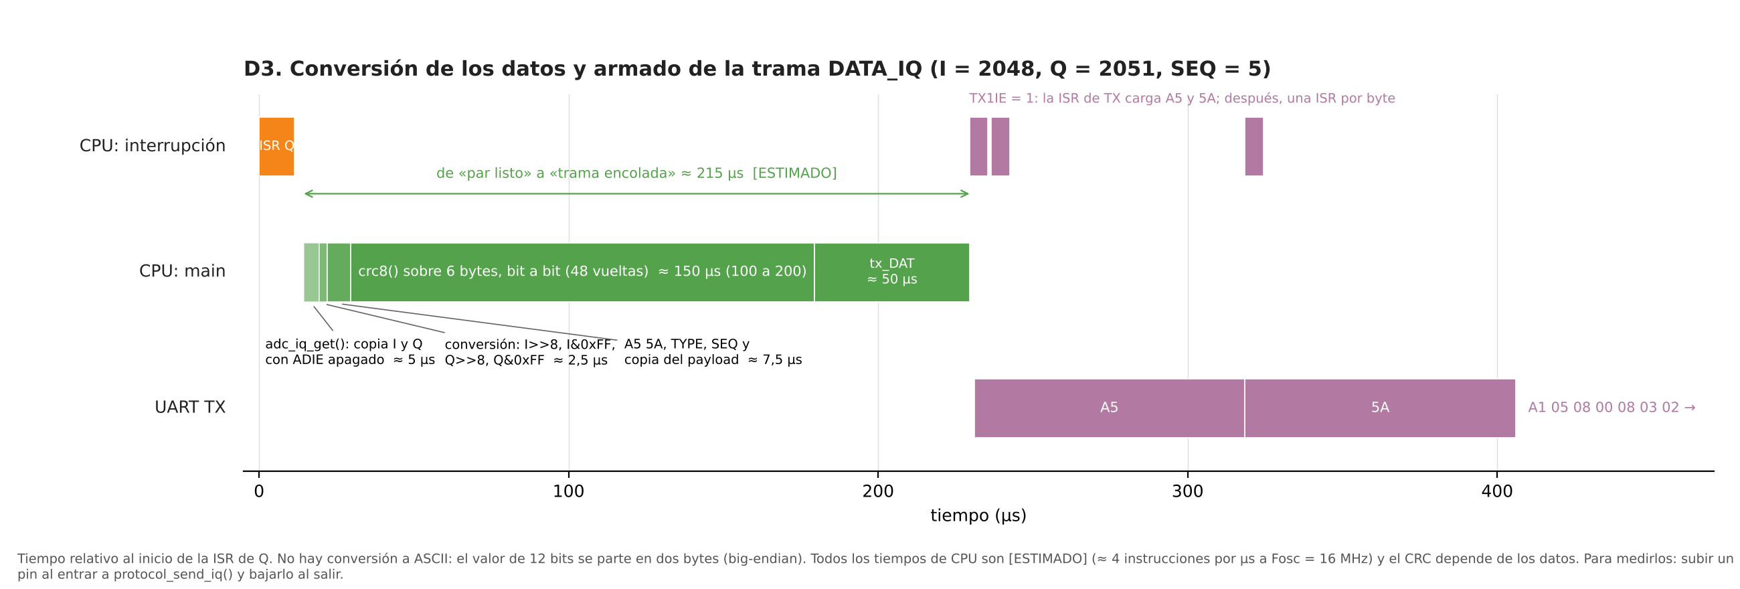
docs/diagramas_tiempo/D3_armado_trama.png
