juancalderonlaratilin-ai/micro3/docs/diagramas_tiempo/matlab/figuras/fig3_armado_linea.png

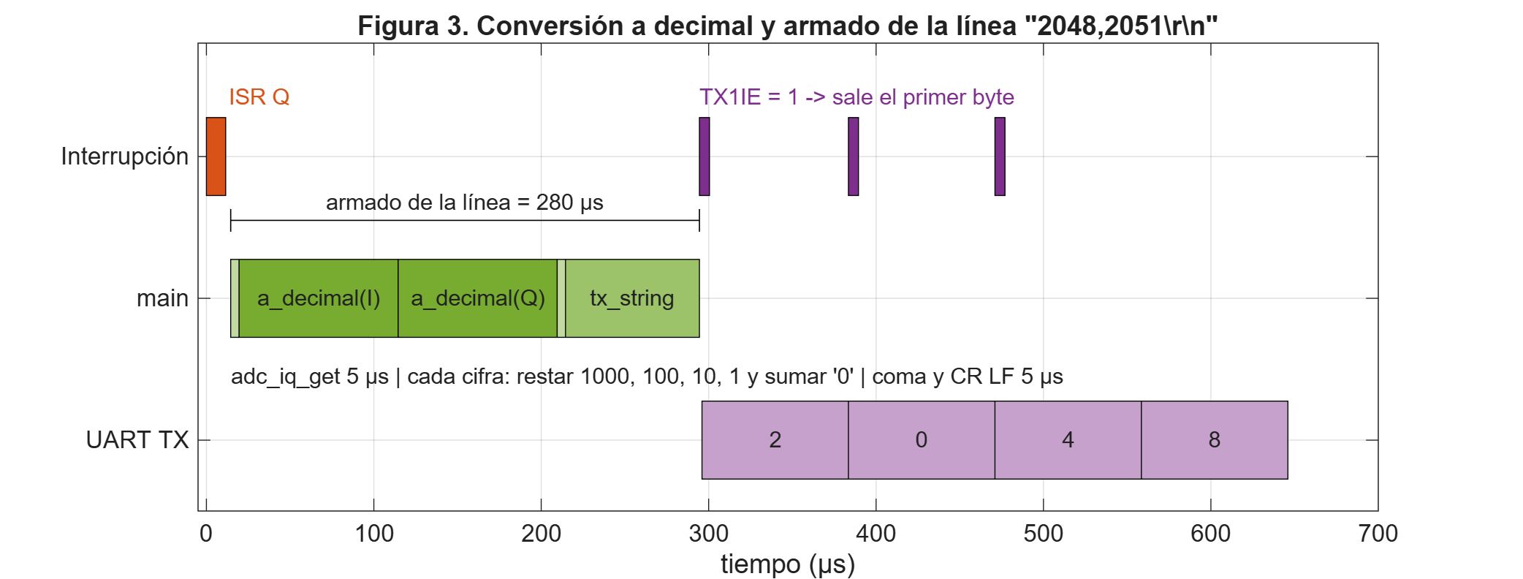
docs/diagramas_tiempo/matlab/figuras/fig3_armado_linea.png
