juancalderonlaratilin-ai/micro3/docs/informe/figuras/fig3_armado_trama.png

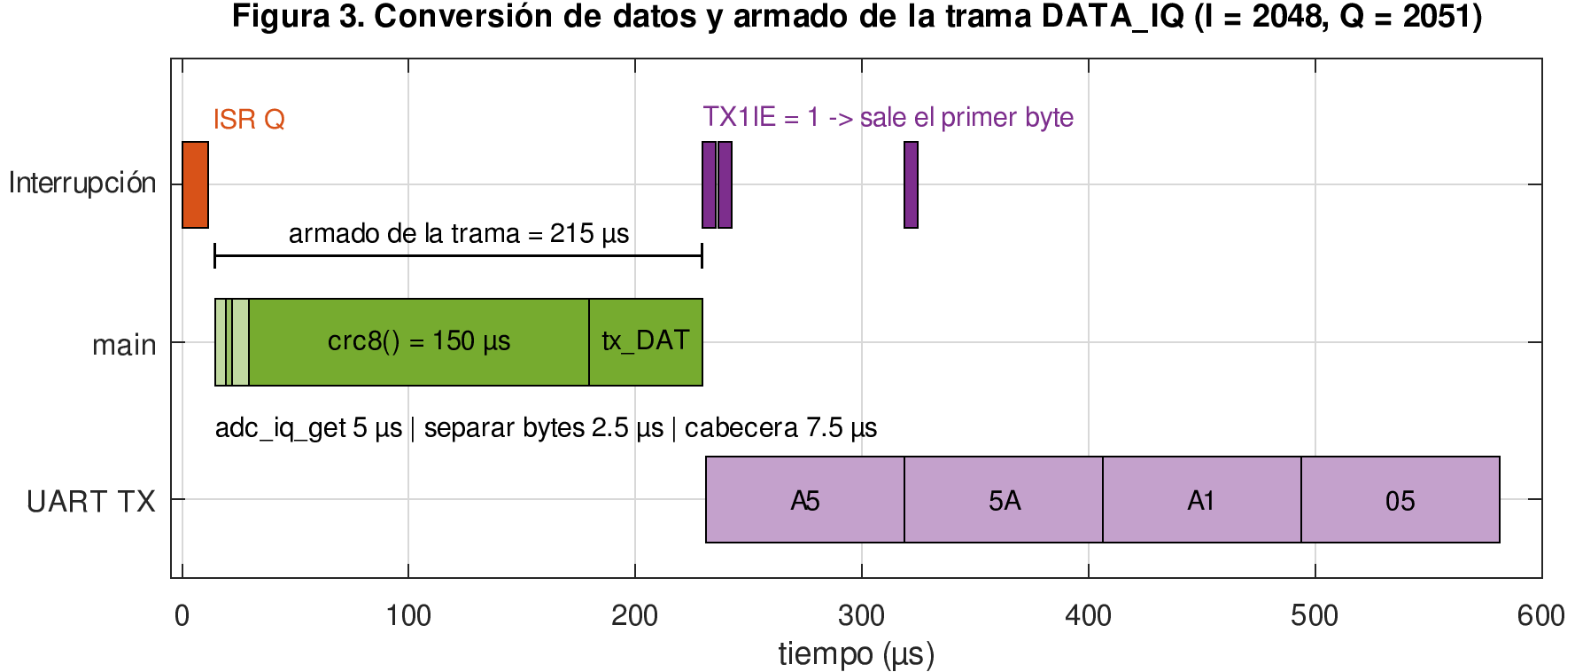
docs/informe/figuras/fig3_armado_trama.png
