juancalderonlaratilin-ai/micro3/(list of files, drawings)

Other design files:
hardware/EsquematicoAntefinal3_R_COINCIDEN_PRACTICA1_v3_2_CAP_RES0603.SchDoc
hardware/PCB1.PcbDoc
hardware/PCB1y2.PcbDoc
hardware/pcbPRUEBA5.PrjPcb
