juancalderonlaratilin-ai/micro3/(commit log)

2026-10-16 Proyecto inicial: especificacion UART y proyecto MPLAB
2026-10-16 Dejar de versionar hardware
2026-10-16 docs: especificacion, criterios, protocolos y circuito UART
2026-10-16 docs: estado y bitácora de avance
2026-10-19 docs: roles Gemini y Claude Code, enunciado de la practica 3
2026-10-19 docs: decision y motivos del tamaño de los buffers
2026-10-19 docs: protocolos de desarrollo de codigo y cambio de MCC usable
2026-10-19 segundo cambio de buffers
2026-10-19 cambios de buffer de tx a 64 y rx a 32
2026-10-19 Codigo por ahora cambiado de usart para no tener bloqueos de cpu, protocolos,especificaciones y demas cambiado
2026-10-20 docs: resultados pruebas UART 1.5, 1.6 y 1.7
2026-10-20 docs: resultados pruebas UART 1.5-1.7 y 0.3
2026-10-20 Cambios aprobados para usart
2026-10-20 heartbeat para probar usart a la vez que se hace algo mas
2026-10-20 UART: pruebas 0.3, 0.5, 1.5-1.7 y 1.12; T-02 y T-05 probadas; C-01 a C-04
2026-10-21 quite todo hearbeart para seguir con pwm
2026-10-21 eventos,tareas,especificaciones de formato CRC8
2026-10-30 T-09: ADC I/Q a 1 kHz y trama DATA_IQ (código recibido, sin probar)
2026-10-30 docs: especificaciones para el preinforme, ADC (disparo, ADACQ, Zout, Vref) y avisos en CLAUDE.md
    Agrega docs/especificaciones_preinforme.md y el datasheet del MCP604.
2026-11-03 T-09: ADC sin promedio (una muestra por par, 1000 tramas/s)
2026-11-04 Docs: diagramas de tiempo, informe ADC/UART, guias LabVIEW y receptor Python
2026-11-05 T-06 y T-09: solo envio ASCII (I,Q sin nombres) y PWM por canal que reconstruye I y Q
    - Se quita la trama binaria con CRC-8 (crc8.*, protocol.*); adc_prueba pasa a adc_ascii con adc_ascii_par(i, q)
    - Linea 2048,2051\r\n cada 2 pares = 500 lineas/s (48,1 % de la UART)
    - pwm.c/.h: PWM6 en RA2 (I) y PWM7 en RA4 (Q), Timer2 T2PR=255, duty = (codigo+2)>>2
    - RC2 con la salida del Timer0 para el osciloscopio
    - Auto-cero pasa a Macro (docs/macro_autocero_pwm.md); docs, pruebas, interfaz Python y prompt de Claude Code actualizados
2026-11-05 docs: coherencia de los .md con el codigo y documento tecnico
    - Tabla 'Que tiene esta entrega' en MASTER_PLAN.md: ADC con Timer0 a 1 kHz por canal, PWM6/PWM7 con Timer2 desde cada par muestreado, UART a 500 lineas/s, sin filtro anti-aliasing
    - Nuevo docs/documento_tecnico_micro3.md: especificaciones, formulas, flujo del codigo, funciones, cambios C-01 a C-12 frente a MCC y preguntas de evaluacion
    - Correcciones: RX en Schmitt (INLVLC = 0x3F), RC2 = TMR0_out, prioridad de la ISR TX/RX/ADC, sin LED, T-07 pasa a Macro, estado de compilacion con XC8 2.40
    Sin cambios en el firmware.
